Locleabc/DryMachine/docs/wiring.html

DryMachine · bộ điều khiển máy sấy tách ẩm

# Sơ đồ đấu dây STM32F103C8T6

Gán chân và cách nối từng module cho bản firmware hiện tại (Keil MDK, SHT45, relay 5V opto, nguồn tổ ong 12V). Tên User Label khớp với board.c trong repo.

MCU 3.3V12V → 5V → 3.3V25 chân đã dùng · 5 dự phòngRelay kích mức THẤP

## Chân trên Blue Pill

- Nguồn
- GND
- TFT · SPI1
- SHT45 · I2C2
- NTC dàn lạnh · ADC
- Relay
- Nút bấm
- Nạp / log
- Trống

Nhìn mặt linh kiện, cổng USB bên trái. Thứ tự in trên các bản clone có thể khác, hãy đối chiếu chữ in trên board trước khi hàn. Chân viền xám là chân trống; PA11/PA12 để trống vì dính USB, PA12 có sẵn điện trở kéo lên 1.5kΩ.

## Sơ đồ khối hệ thống

Nguồn đi từ trái sang, tín hiệu cảm biến vào bên phải, lệnh relay đi xuống dưới. Ray 5V từ buck cấp cho chân 5V Blue Pill, JD-VCC module relay, VCC màn hình TFT; ray 3.3V cấp thêm phân áp NTC; ray 3.3V lấy từ LDO trên Blue Pill.

## Hai chỗ dễ đấu sai

Mỗi NTC một mạch như trên (NTC buồng → PA0, NTC dàn lạnh → PA6). Dùng 3.3V của Blue Pill (không dùng 5V – ADC chỉ chịu 3.3V). NTC không phân cực.

Tháo jumper VCC–JD-VCC để cách ly: phía opto nuôi 3.3V từ Blue Pill, cuộn relay nuôi 5V từ buck. Máy nén không đi thẳng qua relay module: K1 chỉ đóng cuộn contactor KM, tiếp điểm chính của KM mới cấp cho máy nén (giữ nguyên rơ-le nhiệt OLR và tụ đề của điều hoà).

## Bảng nối dây từng module

### Nguồn

Chân module | Nối tới | Ghi chú
Nguồn tổ ong V+ 12V | Buck IN+ | CB 10A + cầu chì 1A phía 220V
Buck OUT+ 5V | Blue Pill 5V · relay JD-VCC · TFT VCC | Chỉnh buck đúng 5.0V trước khi nối
Buck OUT− / 12V V− | GND chung toàn mạch | Nối sao về một điểm
Blue Pill 3.3 | SHT45 VDD · phân áp 2 NTC · relay VCC (opto) | LDO onboard ~300 mA, đủ cho tải này

### TFT 3.2" ILI9341 (SPI1)

Chân module | Nối tới | Ghi chú
VCC | 5V | Module có LDO 3.3V riêng
GND | GND
CS | PA4
RESET | PB1
DC/RS | PB0
SDI (MOSI) | PA7
SCK | PA5
SDO (MISO) | — để trống | PA6 dùng cho NTC dàn lạnh
LED | PA11 | Đèn nền – firmware tắt khi không bấm nút (tự tắt màn hình). Không dùng: nối 3.3V
T_CLK … T_IRQ | để trống | Cảm ứng chưa dùng

### SHT45 (I2C2)

Chân module | Nối tới | Ghi chú
VDD | 3.3V | Tụ 100nF sát cảm biến
GND | GND
SCL | PB10 | Pull-up 4.7kΩ lên 3.3V nếu module chưa có
SDA | PB11 | Pull-up 4.7kΩ lên 3.3V; dây ≤ 1 m, cáp xoắn

### 2 NTC: buồng sấy (PA0) + dàn lạnh (PA6)

Dây | Nối tới | Ghi chú
NTC buồng – dây A | PA0 | 10kΩ 1% từ PA0 lên 3.3V, tụ 100nF PA0–GND
NTC buồng – dây B | GND | Đầu dò chịu nhiệt (vỏ inox), đặt giữa buồng, tránh gió trực tiếp từ dàn nóng
NTC dàn lạnh – dây A | PA6 | 10kΩ 1% từ PA6 lên 3.3V, tụ 100nF PA6–GND
NTC dàn lạnh – dây B | GND | Kẹp đầu dò sát ống đồng dàn lạnh (đầu ra van tiết lưu / cuối dàn)

### Module relay 3 kênh 5V opto

Chân module | Nối tới | Ghi chú
VCC | 3.3V | Nuôi opto bằng 3.3V để tắt dứt khoát
GND | GND
IN1 | PB4 | Máy nén (qua contactor) – kích mức CAO; 10kΩ PB4→GND
IN2 | PB5 | Quạt dàn lạnh
IN3 | PB6 | Quạt dàn nóng S1 (cấp ≥ 1)
IN4 | PB7 | Quạt dàn nóng S2 (cấp ≥ 2)
IN5 | PA1 | Quạt dàn nóng S3 (cấp ≥ 3)
IN6 | PA2 | Quạt dàn nóng S4 (cấp ≥ 4)
IN7 | PA3 | Quạt dàn nóng S5 (cấp 5)
JD-VCC | 5V buck | Tháo jumper VCC–JD-VCC
GND (cạnh JD-VCC) | GND buck

### Nút bấm (pull-up nội)

Chân module | Nối tới | Ghi chú
UP | PB8 ↔ GND
DOWN | PB9 ↔ GND
ENTER | PA8 ↔ GND
EXIT | PA15 ↔ GND | Cần SYS Debug = Serial Wire

### Nạp code & log

Chân module | Nối tới | Ghi chú
ST-Link SWDIO / SWCLK | Header SWD (PA13 / PA14) | Kèm GND, 3.3V
USB-UART RX | PA9 (TX) | 115200 8N1
USB-UART TX | PA10 (RX)
USB-UART GND | GND | Không nối 5V của USB-UART khi board đã có nguồn

## Cấu hình chân trong CubeMX

Đặt đúng User Label để main.h sinh ra các macro mà board.c dùng. SYS → Debug = Serial Wire (giải phóng PA15, PB3, PB4). Chân dự phòng: PB3 (IN8), PA12.

Chân | Chức năng | CubeMX mode | User Label | Mức khởi động
PA0 | NTC buồng sấy | ADC1_IN0 | NTC_EVAP1 | –
PA1 | Relay quạt nóng S3 (IN5) | GPIO_Output | RLY_FAN_S3 | High (= OFF)
PA2 | Relay quạt nóng S4 (IN6) | GPIO_Output | RLY_FAN_S4 | High (= OFF)
PA3 | Relay quạt nóng S5 (IN7) | GPIO_Output | RLY_FAN_S5 | High (= OFF)
PA4 | TFT CS | GPIO_Output | TFT_CS | High
PA5 | TFT SCK | SPI1_SCK | – | –
PA6 | NTC dàn lạnh | ADC1_IN6 | NTC_EVAP2 | –
PA7 | TFT SDI | SPI1_MOSI | – | –
PA8 | Nút ENTER | GPIO_Input, Pull-up | BTN_ENTER | –
PA9 | Log TX | USART1_TX | – | –
PA10 | Log RX | USART1_RX | – | –
PA11 | Đèn nền TFT | GPIO_Output (board.c) | – | High (sáng)
PA13 | SWDIO | SYS_JTMS-SWDIO | – | –
PA14 | SWCLK | SYS_JTCK-SWCLK | – | –
PA15 | Nút EXIT | GPIO_Input, Pull-up | BTN_EXIT | –
PB0 | TFT DC | GPIO_Output | TFT_DC | Low
PB1 | TFT RESET | GPIO_Output | TFT_RST | High
PB4 | Relay máy nén (IN1) | GPIO_Output | RLY_COMP | Low (= OFF, kích mức cao)
PB5 | Relay quạt dàn lạnh (IN2) | GPIO_Output | RLY_FAN_EVAP | High (= OFF)
PB6 | Relay quạt nóng S1 (IN3) | GPIO_Output | RLY_FAN_S1 | High (= OFF)
PB7 | Relay quạt nóng S2 (IN4) | GPIO_Output | RLY_FAN_S2 | High (= OFF)
PB8 | Nút UP | GPIO_Input, Pull-up | BTN_UP | –
PB9 | Nút DOWN | GPIO_Input, Pull-up | BTN_DOWN | –
PB10 | SHT45 SCL | I2C2_SCL | – | –
PB11 | SHT45 SDA | I2C2_SDA | – | –
PC13 | LED chạy | GPIO_Output | LED_RUN | High (LED tắt)

## Trước khi cấp điện 220V

An toàn điệnTách riêng máng dây 220V và dây tín hiệu. Vỏ tủ, dàn và máy nén phải nối đất. Đấu RC snubber (100Ω + 0.1µF X2) hoặc varistor song song cuộn contactor và quạt để relay không đánh lửa làm treo MCU.

1. Chỉnh buck ra đúng 5.0V khi chưa nối tải.
2. Cấp 12V, đo chân 3.3 của Blue Pill được 3.25–3.35V.
3. Tháo jumper VCC–JD-VCC; VCC module relay nối 3.3V, JD-VCC nối 5V.
4. Chưa nối tải 220V, nạp firmware: cả 7 relay phải nhả khi khởi động (PB5–PB7, PA1–PA3 mức High; PB4 máy nén mức Low).
5. Đo PA0 / PA6 ở nhiệt độ phòng (~25 °C): khoảng 2.2V.
6. Log UART hiện nhiệt độ buồng (NTC PA0) hợp lý và SHT45 không báo lỗi (SHTerr đứng yên).
7. Thử bảo vệ: rút NTC buồng (PA0) phải báo Mất cảm biến nhiệt và cắt relay.
8. Sau cùng mới đấu contactor, quạt, máy nén.
