Locleabc/DryMachine/App/app.h

/**
 * @file    app.h
 * @brief   Điểm vào ứng dụng. main.c: App_Init() sau MX_xxx_Init(), App_Loop() trong while(1).
 */
#ifndef APP_H
#define APP_H

void App_Init(void);
void App_Loop(void);

#endif
