Locleabc/DryMachine/(commit log)

2026-09-27 docs: khởi tạo repo, README, sơ đồ chân và hướng dẫn CubeMX
    - Chốt phần cứng: STM32F103C8T6, MAX31865, RS485 Modbus, ILI9341, 3 relay, 4 nút
    - docs/PINOUT.md: bảng gán chân + lưu ý phân áp cảm biến áp suất
    - docs/CUBEMX_SETUP.md: cấu hình ngoại vi và cách gắn App/ vào main.c
    Claude-Session: https://claude.ai/code/session_01Q4RsSUfkgXaCjxshzdnzJP
2026-09-27 feat(bsp): thêm app_config.h, driver relay và nút bấm
    - app_config.h: handle ngoại vi, hằng số hiệu chuẩn PT100/áp suất/RS485, chu kỳ task
    - bsp_relay: 3 relay (máy nén, quạt dàn nóng, quạt dàn lạnh), mức kích cấu hình được
    - bsp_button: 4 nút active-low, chống dội 30 ms, sự kiện CLICK / LONG (1 s) / REPEAT (UP, DOWN)
    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
2026-09-27 feat(sensor): driver PT100/MAX31865, áp suất analog, độ ẩm RS485 Modbus
    - drv_max31865: SPI mode 1, chuyển đổi liên tục, Callendar-Van Dusen, phát hiện lỗi đứt/chập
    - drv_pressure: ADC oversample x8 + lọc EMA, quy đổi 0.5-4.5 V -> bar, báo lỗi đứt dây
    - drv_humidity: Modbus RTU FC04 non-blocking (Transmit + Receive_IT + timeout),
    CRC16, mặc định kiểu XY-MD02 - chỉnh thanh ghi trong app_config.h khi chốt mã cảm biến
    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
2026-09-27 feat(tft): driver ILI9341 SPI + font ASCII 5x7
    - Khởi tạo ILI9341, xoay màn hình (mặc định ngang 320x240), RGB565
    - FillRect dùng buffer dòng 64 px, vẽ ký tự/chuỗi có scale và tô nền (chống nhấp nháy)
    - Font 5x7 ký tự 0x20..0x7E (UI dùng tiếng Việt không dấu)
    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
2026-09-27 fix(button): ENTER/EXIT phát CLICK khi nhả để tách biệt nhấn ngắn và giữ lâu
    Trước đó CLICK phát ngay khi nhấn nên giữ ENTER để Start/Stop sẽ mở menu trước.
    UP/DOWN vẫn phát CLICK khi nhấn + REPEAT khi giữ.
    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
2026-09-27 feat(settings): bảng thông số vận hành lưu Flash + tiện ích định dạng số
    - settings_t: nhiệt/ẩm đặt + trễ, quá nhiệt, áp cao/thấp, thời gian bảo vệ máy nén,
    trễ khởi động, quạt chạy thêm, thời gian sấy, chế độ quạt dàn nóng
    - Bảng param_desc_t (tên, đơn vị, min/max/step) dùng chung cho menu
    - Lưu page 63 (0x0800FC00) với magic + version + CRC32, đọc lại kiểm tra
    - util_fmt: Fmt_Float/Fmt_Time không cần printf float
    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
2026-09-27 feat(ctrl): máy trạng thái điều khiển máy sấy và bảo vệ máy nén
    - Trạng thái IDLE -> STARTING -> RUNNING -> STOPPING, FAULT (latched, reset bằng tay)
    - Máy nén chạy theo nhu cầu nhiệt + ẩm có trễ; mất cảm biến ẩm -> chỉ theo nhiệt (cảnh báo)
    - Bảo vệ: min-off (kể cả sau khi cấp điện), min-on, áp cao, áp thấp (bỏ qua 60 s đầu),
    quá nhiệt, lỗi cảm biến nhiệt/áp (lọc 5 chu kỳ)
    - Quạt dàn lạnh chạy trước máy nén và chạy thêm sau khi dừng
    - Quạt dàn nóng: mode 0 theo máy nén, mode 1 xả nhiệt theo nhiệt độ; ép chạy khi áp >= 90% ngưỡng cao
    - Hẹn giờ sấy (0 = kh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
2026-09-27 feat(ui,app): giao diện TFT + menu cài đặt, bộ lập lịch App_Init/App_Loop
    - ui_menu: màn hình chính (nhiệt/ẩm/áp, trạng thái, 3 relay, dòng lỗi/cảnh báo/thời gian)
    menu thông số cuộn 8 dòng, sửa giá trị UP/DOWN, tự lưu Flash khi thoát menu
    - Phím: ENTER nhấn = menu, giữ ENTER = chạy/dừng, giữ EXIT = reset lỗi
    - Vẽ giá trị 500 ms/lần, có tô nền để không nhấp nháy
    - app.c: lập lịch theo HAL_GetTick (nút 10 ms, cảm biến 500 ms, RS485 1 s,
    điều khiển 200 ms, UI 100 ms, log UART1 2 s, LED 500 ms)
    Claude-Session: https://claude.ai/code/session_01Q4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
    [app.c, app.h]
2026-09-27 test: công cụ kiểm tra biên dịch và test logic điều khiển trên PC
    - tools/host_check/main.h: HAL giả lập + User Label theo PINOUT
    - check.sh: gcc -fsyntax-only -Wall -Wextra toàn bộ App/ (hiện 0 cảnh báo)
    - test_ctrl.c: 17 kịch bản cho ctrl_dryer (khởi động, min-off/min-on, trễ ẩm,
    áp cao, mất cảm biến, dừng + quạt chạy thêm) - tất cả PASS
    - docs: thêm bước giảm FLASH LENGTH xuống 63K để dành page lưu thông số
    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
2026-09-27 docs: chuyển sang Keil MDK-ARM, cảm biến ẩm SHT45 (I2C2), mô tả kiến trúc mới
    - Bỏ RS485/USART2, thêm I2C2 PB10 (SCL) / PB11 (SDA) cho SHT45
    - docs/KEIL_SETUP.md thay CUBEMX_SETUP.md: CubeMX -> MDK-ARM, groups, include paths,
    IROM1 = 0xFC00 để dành page lưu thông số, AC6 + MicroLIB, encoding UTF-8
    - docs/ARCHITECTURE.md: phân tầng board / drivers / services / control / ui / app
    và bảng quy tắc include để các phần không ràng buộc nhau
    - .gitignore cho Keil
    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
2026-09-27 refactor(drivers): tách driver thành module độc lập, nhận cấu hình qua struct
    - Mỗi driver 1 thư mục trong App/drivers/, chỉ include stm32f1xx_hal.h
    (không còn phụ thuộc app_config.h / main.h / tên chân CubeMX)
    - button: bảng button_hw_t truyền vào Init (mức nhấn, cho phép lặp), id = chỉ số bảng
    - relay: bảng relay_hw_t có mức kích riêng từng relay
    - max31865: instance max31865_t + max31865_cfg_t (SPI, CS, Rref, R0, 2/3/4 dây)
    - press_analog: chỉ đọc điện áp + hàm quy đổi thuần; lọc số chuyển lên tầng services
    - ili9341: ili9341_cfg_t (SPI, CS, DC, RST)
    - flash_store (mới): ghi/đọc khối dữ liệu vào p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
2026-09-27 feat(drivers): driver SHT4x (SHT45) qua I2C, đo không chặn
    - Soft reset + đọc serial khi Init
    - StartMeasure / BusyTimeMs / ReadResult để không chặn vòng lặp chính
    - 3 mức chính xác (high 10 ms, medium 5 ms, low 2 ms), kiểm CRC-8 (0x31)
    - Quy đổi T = -45 + 175*S/65535, RH = -6 + 125*S/65535 (kẹp 0..100)
    - Hỗ trợ lệnh heater tích hợp (chống trôi khi độ ẩm cao lâu ngày)
    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
    [sht4x.c, sht4x.h]
2026-09-27 refactor(control): dryer_ctrl thành module logic thuần C, không phụ thuộc phần cứng
    - Không include HAL / relay / settings; không biến toàn cục (instance dryer_ctrl_t)
    - DryerCtrl_Step(ctrl, params, input, now) -> dryer_output_t; app tự đẩy ra relay
    - Lệnh qua DryerCtrl_Command (START/STOP/TOGGLE/RESET_FAULT) thay cho gọi hàm trực tiếp
    - dryer_params_t + DryerCtrl_DefaultParams() định nghĩa ngay tại control
    - Logic giữ nguyên như bản trước (18/18 kịch bản test PASS, xem commit test)
    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
    [dryer_ctrl.c, dryer_ctrl.h]
2026-09-27 refactor(services): tách sensors / settings / log / sched / util_fmt thành dịch vụ độc lập
    - sensors: gom PT100 + SHT45 + áp suất, lọc EMA áp suất, bù sai số, đánh giá hợp lệ;
    SHT45 đọc không chặn mỗi 1 s, lỗi 3 lần -> mất cảm biến ẩm, 5 lần -> gọi bus_recover
    (callback do app/board cung cấp) rồi init lại
    - settings: settings_t chứa dryer_params_t + bù nhiệt/ẩm; lưu qua flash_store
    (cấu hình truyền vào Init), bảng settings_param_t cho menu; version 2
    - log: printf qua hàm ghi truyền vào (không biết UART)
    - sched: bộ lập lịch bảng task tổng quát
    - util_fmt: Fmt_Float không dùng width '*' để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
2026-09-27 refactor(ui): giao diện độc lập với điều khiển, cảm biến và settings
    - ui_view_t: app điền sẵn dữ liệu hiển thị (UI không include dryer_ctrl/sensors)
    - ui_param_if_t: 4 con trỏ hàm count/desc/get/set để menu đọc-sửa thông số bất kỳ
    - ui_cmd_cb_t: UI chỉ phát lệnh START_STOP / RESET_FAULT / SAVE_SETTINGS
    - ui_key_t/ui_press_t riêng, không phụ thuộc driver nút bấm
    - Thời gian truyền vào UI_Update (không gọi HAL_GetTick) -> UI chỉ còn phụ thuộc ili9341
    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
2026-09-27 refactor(app,board): tách cấu hình phần cứng vào board/, app.c chỉ còn là keo nối
    - board.h/.c: bảng relay, nút, cấu hình MAX31865 / SHT45 / áp suất / TFT / page Flash;
    nơi duy nhất include main.h (tên chân CubeMX). Thay thế app_config.h
    - Board_I2cRecover(): 9 xung SCL + STOP + reset khối I2C2 để gỡ treo bus SHT45
    - app.c: khởi tạo module, adapter settings -> ui_param_if_t, xử lý ui_cmd_t,
    chép sensors -> dryer_input_t -> relay, dựng ui_view_t; lập lịch bằng services/sched
    - Xoá thư mục App/Inc, App/Src cũ
    Claude-Session: https://claude.ai/code/session_01Q4RsSUfkgXaCjxshzd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
    [app.c, app.h, board.c]
2026-09-27 test(host_check): kiểm tra cú pháp, quy tắc phụ thuộc giữa tầng và test logic điều khiển
    - stm32f1xx_hal.h + main.h giả lập (thêm I2C, GPIO_Init, RCC reset)
    - check.sh: (1) gcc -Wall -Wextra toàn bộ App/, (2) bắt vi phạm include theo
    docs/ARCHITECTURE.md (driver include driver khác, control dùng HAL, ui dùng settings...),
    (3) chạy test_ctrl
    - test_ctrl.c viết lại cho API DryerCtrl_*, biên dịch KHÔNG cần HAL: 18/18 PASS
    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
    [main.h]
2026-09-27 docs(wiring): sơ đồ đấu dây trực quan + relay opto kích mức thấp
    - docs/wiring.html: sơ đồ chân Blue Pill, sơ đồ khối, mạch phân áp cảm biến áp,
    đấu module relay (JD-VCC) + sơ đồ thang 220V (K1 -> contactor -> máy nén),
    bảng nối dây từng module, bảng cấu hình CubeMX, checklist trước khi cấp điện
    - PINOUT.md: thêm chuỗi nguồn 220V -> 12V -> 5V -> 3.3V, relay khởi động mức High
    - board.c: relay dùng module 5V opto kích mức THẤP (GPIO_PIN_RESET = đóng)
    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
2026-09-27 feat(services): chế độ sấy đặt sẵn, lịch sử lỗi, ngày giờ; settings v3
    - presets: 6 chế độ đặt sẵn (Rau thom, Rau cu, Trai cay, Nam, Thit - Ca, Hat - Nong) + Tu do
    - settings v3: lưu giá trị từng chế độ (sửa được), chế độ đang dùng, thời gian sấy phút;
    bỏ điểm đặt/thời gian sấy khỏi menu kỹ thuật (đã có màn hình riêng)
    - fault_log: 16 lỗi gần nhất (thời điểm + mã), vòng đệm lưu Flash page 62, có CRC
    - datetime: đổi giây-từ-2000 <-> ngày giờ cho bộ đếm RTC 32 bit
    - dryer_ctrl: tên lỗi ngắn gọn (không tiền tố 'LOI:') để dùng cho lịch sử
    - button: giữ lâu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
2026-09-27 feat(ui): giao diện 4 trang, menu chế độ sấy, nhập số từng chữ số
    - Tách UI thành mỗi màn hình 1 file (ui_screen_t), ui_core lo header/footer/chuyển màn hình
    - Trang 1 chính: nhiệt độ/độ ẩm thực tế (số lớn) + điểm đặt, chế độ, trạng thái, relay, thời gian
    - Trang 2 chạy/dừng, trang 3 thời gian sấy HH:MM, trang 4 lịch sử lỗi; UP/DOWN chuyển trang
    - Header có đồng hồ thời gian thực HH:MM:SS
    - Giữ ENTER 3 s: menu 6 chế độ + Tu do + chỉnh đồng hồ; ENTER áp dụng, giữ ENTER sửa chế độ
    - ui_edit: nhập từng chữ số trái sang phải, UP/DOWN đổi số, ENTER sang số kế / l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
2026-09-27 feat(app,board): RTC thời gian thực, nối UI mới với settings/lịch sử lỗi
    - board: Board_RtcInit/Read/Write đọc thẳng bộ đếm RTC (LSE 32.768 kHz), BKP_DR1 đánh dấu đã chỉnh giờ;
    thêm vùng Flash page 62 cho lịch sử lỗi
    - app: xử lý lệnh UI (chọn/sửa chế độ, thời gian sấy, chỉnh giờ, xoá lỗi/lịch sử),
    ghi lịch sử mỗi khi xuất hiện lỗi mới, dựng ui_view_t (đồng hồ, chế độ, lịch sử)
    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
2026-09-27 test(ui): mô phỏng giao diện trên PC với màn hình giả lập
    - ui_sim/ili9341_sim.c: cùng API driver ILI9341, vẽ vào framebuffer, xuất ảnh PPM
    - ui_sim/sim_main.c: chạy nguyên App/ui, bấm phím theo kịch bản, kiểm 8 tình huống
    (chạy/dừng, thời gian sấy 15:30, xoá lỗi, chọn chế độ, Tu do 62C 24%, chỉnh giờ,
    menu kỹ thuật, huỷ nhập) + báo chữ vẽ tràn màn hình
    - check.sh thêm bước 4; stub HAL thêm RTC/BKP
    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
2026-09-27 docs(ui): hướng dẫn giao diện + ảnh màn hình, cấu hình RTC và Flash cho Keil
    - docs/UI.md: bảng phím từng trang/menu, ảnh chụp từ bộ mô phỏng
    - KEIL_SETUP: bật LSE + RTC (không bật Calendar), IROM1 Size = 0xF800
    - PINOUT: thạch anh 32.768 kHz PC14/PC15, pin CR2032 ở VBAT
    - ARCHITECTURE: danh sách file màn hình trong ui/
    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
2026-09-27 build: file CubeMX DryMachine.ioc cấu hình sẵn + script gắn App/ vào Keil
    - DryMachine.ioc: STM32F103C8T6, 72 MHz (HSE x9), LSE + RTC (Activate Clock Source, không Calendar),
    SPI1 (TFT, /4), SPI2 (MAX31865, mode 1, /16), I2C2 100 kHz, USART1 115200, ADC1 IN0 239.5 cycles,
    SWD, đủ User Label + mức khởi động (relay/CS = High, nút pull-up), toolchain MDK-ARM, stack 0x800
    - tools/keil_setup.py: sau khi Generate, thêm nhóm App/* + include path, IROM1 = 0xF800, MicroLIB,
    gnu11, chèn App_Init/App_Loop vào main.c; chạy lại được, giữ bản .bak
    - docs/KEIL_SETUP.md: cách nhanh 3 bước + hướng dẫn làm tay từng mục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
2026-09-27 fix(board): khai báo extern handle HAL ngay trong board.c
    CubeMX bật 'pair .c/.h' nên hspi1/hspi2/hi2c2/hadc1/huart1 nằm trong spi.h, i2c.h... chứ không
    phải main.h -> board.c báo 'undeclared'. Khai báo extern tại board.c để chạy được với cả hai cách sinh code.
    app.c: bỏ cảnh báo format-truncation khi định dạng ngày giờ lịch sử lỗi.
    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
    [app.c, board.c]
2026-09-27 fix(keil_setup): chặn MX_RTC_Init đặt lại giờ 00:00 mỗi lần khởi động
    CubeMX luôn sinh HAL_RTC_SetTime/SetDate trong MX_RTC_Init. Script chèn vào vùng USER CODE
    Check_RTC_BKUP: nếu BKP_DR1 = 0xA5A5 (đã chỉnh giờ) thì return, giữ bộ đếm RTC chạy bằng pin VBAT.
    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
2026-09-27 build: code CubeMX sinh cho Keil MDK-ARM + đã gắn App/
    - Core/, Drivers/ (HAL F1), MDK-ARM/ do STM32CubeMX sinh từ DryMachine.ioc
    - Đã chạy tools/keil_setup.py: 28 file App/*.c trong 6 nhóm, 12 include path, IROM1 = 0xF800,
    MicroLIB, main.c gọi App_Init/App_Loop, rtc.c không xoá giờ khi đã chỉnh
    - Đã kiểm tra: tên chân khớp board.c, SPI2 mode 1, relay/CS khởi động mức High, JTAG tắt (PA15 dùng được)
    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
2026-09-27 test(gcc_check): biên dịch + liên kết toàn bộ firmware bằng arm-none-eabi-gcc
    Bắt lỗi biên dịch/liên kết khi chưa mở Keil. Kết quả hiện tại: 0 lỗi, 0 cảnh báo trong App/,
    Flash 37.1 KB / 62 KB, RAM ~4 KB / 20 KB (gồm stack 2 KB).
    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
2026-09-28 fix(keil): IROM1 bắt đầu 0x08000000 – sửa lỗi 'Flash Download failed - Cortex-M3'
    keil_setup.py chỉ đặt Size = 0xF800 mà không đặt StartAddress; CubeMX để trống (= 0x0) nên
    chương trình bị liên kết ở 0x00000000 (map: LR_IROM1 Base 0x00000000) và ST-Link không nạp được.
    - uvprojx: IROM1 = 0x8000000 / 0xF800
    - keil_setup.py: luôn đặt cả StartAddress; chỉ tạo .bak lần đầu (không ghi đè bản gốc khi chạy lại)
    - Kèm cấu hình Keil đã lưu (pack STM32F1xx_DFP 2.4.1, ARMCC 5.06, ST-Link SWD) và RTE/
    Claude-Session: https://claude.ai/code/session_01Q4RsSUfkgXaCjxshzdnz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
2026-09-28 chore: push.bat – bấm đúp để đẩy code lên GitHub
    Tự thêm safe.directory (repo được tạo từ máy ảo nên Git for Windows báo 'dubious ownership'),
    đặt remote origin = https://github.com/Locleabc/DryMachine.git rồi git push -u origin main.
    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
2026-09-28 feat(font): bộ tạo font tiếng Việt + font Be Vietnam Pro dạng bitmap
    - tools/fontgen/fontgen.py: TTF -> bitmap anti-alias 2 bit/pixel, cắt sát phần có mực, sinh fonts_vn.c
    - font_vn16 (15 px, 233 ký tự: ASCII + 134 chữ cái có dấu + ° · • – …) ~9.5 KB
    - font_num (46 px, 0-9 . - : % ° C) ~3.8 KB cho số lớn
    - Be Vietnam Pro, SIL Open Font License 1.1 (tools/fontgen/OFL.txt)
    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
2026-09-28 feat(ili9341): vẽ chữ UTF-8 tiếng Việt anti-alias
    - ILI9341_BlitBegin/BlitPixels/BlitEnd: đẩy khối điểm ảnh tuỳ ý
    - ili9341_text: giải mã UTF-8, tìm glyph nhị phân, trộn màu 4 mức, Text_Draw / Text_Width /
    Text_Box (căn trái-giữa-phải, tô nền phần thừa để xoá chữ cũ, không vẽ ký tự bị cắt)
    - fonts_vn.c sinh tự động
    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
2026-09-28 feat(ui): giao diện tiếng Việt có dấu, bố cục theo pixel
    - Mọi màn hình dùng font_vn16; số đo lớn, thời gian sấy, màn nhập số dùng font_num
    - Widget đổi sang ô rộng theo pixel (w_text/w_num/w_label), header/footer vẽ lại theo font mới
    - Nhập số: đọc chuỗi UTF-8, hỗ trợ xuống dòng; chỉnh đồng hồ 2 dòng (ngày-tháng-năm / giờ:phút)
    - Chuỗi tiếng Việt: tên chế độ, tên lỗi, trạng thái, thông số kỹ thuật, thông báo, màn khởi động
    - ui_view_t thêm hum_reached (độ ẩm đạt mục tiêu -> số màu xanh)
    Claude-Session: https://cla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
2026-09-28 build/test: Keil --no_multibyte_chars cho ARMCC 5, mô phỏng + kiểm tra phụ thuộc cho font mới
    - keil_setup.py: thêm --no_multibyte_chars (chuỗi UTF-8), 2 file .c mới vào nhóm App/drivers
    - check.sh: driver được include header cùng thư mục; mô phỏng biên dịch kèm font + text
    - ui_sim: giả lập Blit; docs/UI.md: mục font + ảnh màn hình tiếng Việt
    - Build thử arm-none-eabi-gcc: 51.5 KB / 62 KB Flash
    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
2026-09-28 feat(control): chế độ Tự động / Thủ công 5 giai đoạn, quạt dàn nóng 5 cấp
    - Tự động: quạt cấp auto_fan (mặc định 3); máy nén chạy liên tục tới khi đạt độ ẩm -> dừng,
    sau đó giữ nhiệt độ bỏ qua độ ẩm tới hết thời gian sấy -> làm mát tới nhiệt độ dừng -> kết thúc
    - Thủ công: GĐ1 quạt chạy trước 60 s rồi máy nén chạy tới nhiệt độ đặt, GĐ2 giữ nhiệt tới độ ẩm đặt,
    GĐ3/GĐ4 giữ nhiệt theo phút, GĐ5 tắt máy nén làm mát tới nhiệt độ dừng; mỗi GĐ 1 cấp quạt;
    bỏ qua thời gian sấy trang 3
    - Máy nén chờ bật lại (comp_min_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
2026-09-28 feat(settings,board): thông số chu trình v4 + 5 relay tốc độ quạt dàn nóng
    - settings v4: chế độ điều khiển (chữ Tự động/Thủ công), cấp quạt tự động + từng GĐ, GĐ1 quạt chạy trước,
    thời gian GĐ3/GĐ4, nhiệt độ dừng GĐ5, máy nén chờ bật lại, nhiệt độ bảo vệ; chia 2 nhóm
    (trang chu trình / menu kỹ thuật); tham số có thể hiển thị dạng chữ (choices)
    - board: relay COMP, FAN_EVAP, FAN_S1..S5 (PB6, PA1, PA2, PA3, PB4), module relay 8 kênh
    - DryMachine.ioc + Core/Inc/main.h + Core/Src/gpio.c: thêm PA1/PA2/PA3/PB4 output mức High,
    PB6 đổi nhãn RLY_FAN_S1 (sửa sẵn code sinh, không b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
2026-09-28 feat(ui): trang 4 Quạt dàn nóng, danh sách cài đặt dùng chung, hiển thị giai đoạn
    - 5 trang: Chính, Chạy/Dừng, Thời gian sấy, Quạt dàn nóng, Lịch sử lỗi
    - Trang 4: chế độ, bảng 5 GĐ kèm cấp quạt (tô GĐ đang chạy), bảo vệ; ENTER -> danh sách cài đặt
    - ui_list (thay ui_menu_tech): danh sách thông số dùng chung cho menu kỹ thuật và cài đặt chu trình,
    giá trị dạng chữ (Tự động/Thủ công, Tắt/Bật)
    - Trang chính: giai đoạn đang chạy, badge QN + cấp quạt, còn lại theo chế độ
    - Trang 2: thêm dòng giai đoạn + chế độ; trang 3: báo không áp dụng khi Thủ công
    - app: nố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
2026-09-28 docs/build: hướng dẫn chế độ điều khiển + ảnh màn hình, cập nhật project Keil
    - docs/UI.md: 5 trang, mô tả Tự động / Thủ công 5 GĐ, bảo vệ máy nén
    - Keil: thêm fan_speed.c, ui_page_fan.c, ui_list.c (bỏ ui_menu_tech.c)
    - Build thử arm-none-eabi-gcc: 55.8 KB / 62 KB Flash
    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
2026-09-28 feat(sim): chế độ chạy giả lập khi chưa có cảm biến
    - services/sim_plant: mô hình buồng sấy thuần C (máy nén -> nóng + khô, quạt dàn nóng xả nhiệt,
    tắt máy nén -> nguội + ẩm tăng lại, áp suất theo máy nén)
    - app: nguồn số đo chọn giữa cảm biến thật / Mô hình / Chỉnh tay; đồng hồ bộ điều khiển tua nhanh
    x1/x10/x60/x300 (khoá liên động quạt vẫn theo thời gian thật); tạo lỗi mất CB nhiệt / ẩm / áp cao;
    relay thật mặc định TẮT khi giả lập; chỉ lưu RAM (reset = tắt giả lập); log UART gắn [SIM]
    - UI: giữ EXIT 3 s ở trang 2 mở danh sách GIẢ LẬP (không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
    [app.c, sim_plant.c, sim_plant.h]
2026-09-28 test/docs: chạy trọn chu trình với mô hình buồng sấy + hướng dẫn giả lập
    - tools/host_check/sim_cycle.c (bước 5 của check.sh): dryer_ctrl + sim_plant, in mốc từng giai đoạn
    Tự động ~256 phút, Thủ công ~240 phút, cả hai HOÀN THÀNH
    - ui_sim: kiểm tra mở giả lập, thoát không lưu Flash
    - docs/UI.md: mục Chạy giả lập, cách thử từng giai đoạn
    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
2026-09-28 feat(ui): trang 6 – trạng thái đầu ra relay ON/OFF
    - ui_page_outputs.c: 7 đầu ra (máy nén, quạt dàn lạnh, quạt nóng cấp 1–5) kèm chân IN/GPIO
    - ô ON xanh / OFF xám; giả lập không đóng relay → ON* vàng + ghi chú
    - view thêm out_cmd (yêu cầu) / out_relay (Relay_Get), cfg thêm output_names/pins
    - footer 6 ô số trang, docs/UI.md + ảnh màn hình
    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
2026-09-28 feat(sim): giả lập mặc định đóng relay thật để đo điện áp chân ra
    - "Relay thật" mặc định Bật: chân GPIO + relay chạy theo bộ điều khiển khi giả lập
    - trang 6: ENTER đảo Relay thật khi đang giả lập (UI_CMD_SIM_RELAY)
    - trang 6 ghi chú mức chân ra: ON = 0 V, OFF = 3.3 V (relay kích mức thấp)
    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
2026-09-28 fix(sim): bật giả lập tự xoá lỗi mất cảm biến để chạy được khi chưa gắn cảm biến
    - chưa gắn PT100 → khởi động báo "Mất cảm biến nhiệt" và khoá máy; vào giả lập gửi RESET_FAULT
    - thông báo "Đang lỗi – xem trang 5" (trang lỗi đã dời)
    - test_ctrl: kịch bản không cảm biến → giả lập → chạy (bảo vệ áp suất = Tắt)
    - docs: hướng dẫn chạy khi chưa có cảm biến nhiệt / áp suất
    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
    [app.c]
2026-09-28 feat(ui): test đầu ra – bật/tắt tay từng relay ở trang 6
    - ENTER vào test (chỉ khi máy Đang dừng / Lỗi), UP/DOWN chọn, ENTER bật/tắt, EXIT thoát + tắt hết
    - quạt dàn nóng vẫn qua khoá liên động 1 cấp + nghỉ 1 s; máy nén giữ thời gian chờ bật lại
    - test luôn đóng relay thật; chặn chạy sấy khi đang test; 10 phút không bấm → tự thoát
    - bỏ UI_CMD_SIM_RELAY (Relay thật chỉnh trong danh sách GIẢ LẬP)
    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
2026-09-29 feat(ctrl): quá nhiệt – làm mát cưỡng bức tới 30 °C mới hết lỗi
    - quá nhiệt: tắt máy nén, quạt dàn lạnh + quạt dàn nóng cấp 5 chạy liên tục
    - nhiệt độ ≤ "Quá nhiệt: nguội tới" (mặc định 30 °C, trang 4) → tự hết lỗi, về IDLE
    - chưa nguội thì không reset được lỗi, khoá test đầu ra; màn hình "Quá nhiệt · làm mát tới 30°C"
    - settings v5: ô hum_hyst (không dùng) → temp_recover, đọc được v4 giữ nguyên cài đặt cũ
    - sim_plant môi trường 28 °C; test_ctrl + sim_cycle quanhiet
    Claude-Session: https://claude.ai/code/session_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
    [app.c, dryer_ctrl.c, dryer_ctrl.h, settings.c, settings.h, sim_plant.c]
2026-09-29 feat(ui): trang 6 hiện nhiệt độ · độ ẩm · áp suất thay dòng ghi chú ON/OFF
    - dòng dưới cùng: T (cam) · RH (xanh) · áp suất bar, "--.-" khi mất cảm biến
    - chế độ test báo ở footer "TEST · ENTER bật/tắt · EXIT thoát"
    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
2026-10-04 fix(sht45): chẩn đoán lý do không đọc được + tự dò địa chỉ 0x44/0x45
    - driver phân biệt lỗi: không trả lời (NACK), bus bị giữ thấp (BUSY), CRC, timeout
    - SHT4X_Init tự thử địa chỉ còn lại khi không trả lời
    - khởi động gỡ treo bus I2C trước khi init (cờ BUSY kẹt của I2C STM32F1)
    - dòng cảnh báo trang chính ghi rõ lý do; log UART in địa chỉ + mã lỗi
    - docs/PINOUT.md: bảng xử lý sự cố SHT45
    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
    [app.c, sensors.c, sensors.h, sht4x.c, sht4x.h]
2026-10-04 feat(sensors): hỗ trợ SHT3x (SHT31-D) + chẩn đoán lỗi MAX31865/PT100
    - driver sht4x tự nhận SHT4x (lệnh 1 byte) hoặc SHT3x (lệnh 2 byte, RH = 100·raw/65535)
    - trang chính ghi rõ lý do mất PT100 theo thanh ghi lỗi MAX31865 (không phản hồi SPI, hở, chập, sai jumper, sai Rref)
    - log khởi động in loại SHT, địa chỉ, mã lỗi và thanh ghi lỗi PT100
    - docs/PINOUT.md: đấu SHT31-D, jumper 2/3/4 dây MAX31865, bảng xử lý sự cố
    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
2026-10-04 feat(ui): hiện nhiệt độ đo tại cảm biến ẩm SHT ở trang chính
    - dòng "Chế độ" bên phải: "SHT 28.3°C" (chỉ tham khảo, điều khiển vẫn dùng PT100)
    - ẩn khi cảm biến ẩm không đọc được
    Claude-Session: https://claude.ai/code/session_017fUgYe1KjDaqZScqSxtEce
2026-10-04 fix(pt100): lỗi "ngoài dải" hiện điện trở đo được + gợi ý nguyên nhân
    - driver MAX31865 trả thêm mã ADC, luôn có R kể cả khi nhiệt ngoài -50..250 °C
    - dòng cảnh báo: "PT100 R=xx ohm thấp: chập / Rref?" | "cao: hở / PT1000?" | "ngoài dải"
    - log UART lúc khởi động in thêm R của PT100
    - docs/PINOUT.md: bảng tra theo R + cách đo kiểm bằng đồng hồ
    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
    [app.c, max31865.c, max31865.h, sensors.c, sensors.h]
2026-10-04 docs(pinout): sửa cách hàn jumper + đấu dây PT100 3 dây cho MAX31865
    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
2026-10-04 feat(ui): tự tắt màn hình khi không bấm nút, bấm nút bất kỳ để sáng lại
    - thông số mới trang 4 "Tắt màn hình sau" (phút, mặc định 5, 0 = luôn sáng)
    - tắt: tô đen + tắt đèn nền TFT qua PA11 (cấu hình trong board.c, không sửa CubeMX)
    - bấm nút bất kỳ → sáng lại, lần bấm đánh thức bị bỏ qua tới khi nhả hết nút
    - có lỗi mới → tự sáng lại
    - settings v6, đọc được v4/v5 (giữ nguyên cài đặt cũ)
    - docs: UI.md, PINOUT.md, wiring.html
    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
2026-10-04 refactor(settings): chuyển "Tắt màn hình sau" sang menu kỹ thuật (giữ EXIT 3 s)
    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
2026-10-04 fix(pt100): lỗi giữ lại hiện lý do lúc hỏng, không lấy giá trị đang đo
    - chụp thanh ghi lỗi + R tại thời điểm PT100 hỏng (trước đây lấy R hiện tại → đọc lại
    được vẫn ghi "ngoài dải" với R bình thường, gây hiểu nhầm)
    - PT100 đã đọc lại nhưng lỗi còn giữ: dòng lỗi luân phiên 2 s lý do / "PT100 đã OK lại · xoá lỗi ở trang 5"
    - log UART mỗi lần hỏng: F, R, số lần (phát hiện chập chờn)
    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
    [app.c]
2026-10-05 fix(pt100): chờ 5 s sau bật nguồn mới khởi tạo + đọc MAX31865
    Mới bật nguồn hay báo "PT100 ngoài dải" và khoá máy (phải xoá lỗi tay).
    - MAX31865_Init chuyển từ Sensors_Init sang Sensors_Process sau SENSORS_PT100_START_MS (5 s)
    - trong lúc chờ: chưa chạy bộ điều khiển (relay nhả, không đếm mất cảm biến),
    trang chính hiện "Đang chờ cảm biến nhiệt…"
    - sensors_data_t.pt100_ready; log "PT100 hong" bỏ qua khi chưa sẵn sàng
    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
    [app.c, sensors.c, sensors.h]
2026-10-05 fix(max31865): tự phát hiện chip mất cấu hình và ghi lại, không cần rút nguồn module
    - mỗi lần đọc: đọc lại thanh ghi cấu hình, khác giá trị mong đợi (chip vừa cấp nguồn lại /
    sụt áp / nhiễu → 0x00, VBIAS tắt, RTD = 0) → đồng bộ SPI + ghi lại cấu hình, lần đọc sau có số
    - Init: phát 1 byte giả để SCK về mức nghỉ, ghi + đọc lại cấu hình (thử 3 lần)
    - 0xFFFF (MISO kẹt cao) cũng tính là không phản hồi (trước bị nhầm thành "hở mạch")
    - chẩn đoán: "MAX31865 không phản hồi (CFG=00/FF)" / "sai cấu hình"; log UART thêm CFG + số lần ghi lại
    - docs/PINOUT.md: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
    [app.c, max31865.c, max31865.h, sensors.c, sensors.h]
2026-10-05 feat(fan): quạt dàn nóng 5 cấp kiểu cộng dồn – cấp N đóng relay 1..N
    - cấp 1 = 1 relay … cấp 5 = 5 relay (trước: chỉ 1 relay theo cấp, đổi cấp nghỉ 1 s)
    - tăng cấp: đóng thêm từng relay cách 1 s (giảm dòng khởi động); giảm cấp / tắt: nhả ngay
    - test đầu ra trang 6: ENTER dòng cấp N → relay 1..N, bấm lại → cấp N-1
    - test logic + docs (PINOUT bảng relay theo cấp, cảnh báo không dùng cho motor nhiều đầu dây)
    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
2026-10-06 refactor(board): đổi chân relay cho tiện đi dây
    IN1 máy nén PB4 · IN2 quạt dàn lạnh PB5 · IN3..IN7 quạt dàn nóng S1..S5 = PB6, PB7, PA1, PA2, PA3
    - main.h / gpio.c / DryMachine.ioc (giữ nguyên User Label, chỉ đổi chân)
    - trang test đầu ra: ghi chú chân mới
    - docs PINOUT.md, wiring.html
    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
2026-10-06 feat(sensors): bỏ cảm biến áp suất, thêm 2 NTC 20k dàn lạnh + chống đóng băng
    Phần cứng
    - NTC dàn lạnh 1 → PA0 (ADC1_IN0), NTC 2 → PA6 (ADC1_IN6); mỗi NTC phân áp 20k 1% lên 3.3V + 100 nF
    - SPI1 (TFT) chỉ phát: bỏ MISO PA6; main.h/adc.c/spi.c/.ioc cập nhật nhãn NTC_EVAP1/2
    - driver mới drivers/ntc (tự chọn kênh ADC, phát hiện hở/chập, công thức B); xoá drivers/press_analog
    Điều khiển
    - chống đóng băng: dàn lạnh (thấp nhất của 2 NTC) ≤ −2 °C liên tục 60 s khi máy nén chạy → xả đá:
    tắt máy nén, quạt vẫn chạy, không dừng máy; ≥ 5 °C → chạy tiếp. Mất NTC chỉ cảnh bá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
2026-10-06 docs(sensors): sửa chú thích chu kỳ đọc
    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
2026-10-06 hw(ntc): điện trở phân áp NTC dàn lạnh 10k thay 20k
    r_fixed = 10000 trong board.c; docs cập nhật điện áp tham chiếu (25 °C ≈ 2.2 V, 0 °C ≈ 2.87 V)
    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
2026-10-13 fix(ntc): lọc gai nhiễu + chống báo mất NTC chập chờn
    Hay báo "Mất NTC dàn lạnh (PA0/PA6)" thoáng qua dù dây tốt.
    - NTC_ReadCode: bỏ mẫu ADC timeout (trước tính là 0), sắp xếp và bỏ 1/4 mẫu thấp + 1/4 mẫu cao
    (gai nhiễu từ relay / dây dài) rồi mới lấy trung bình
    - sensors: chỉ báo mất NTC sau 6 lần đọc lỗi liên tiếp (3 s); trong lúc đó giữ giá trị cũ
    - chẩn đoán: trang 6 hiện điện áp chân ADC khi NTC lỗi; log UART thêm mã ADC + số lần đọc lỗi
    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
2026-10-13 fix(build): Flash đầy (L6406E) – MAX31865 đọc bằng HAL_SPI_TransmitReceive
    Image vượt IROM 0xF800 (62 KB, chừa 2 page cuối cho cài đặt + lịch sử lỗi) 0x58 byte.
    read_regs dùng 1 lần TransmitReceive thay Transmit + Receive → không link HAL_SPI_Receive
    và SPI_EndRxTransaction (~0.43 KB).
    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
2026-10-13 fix(ntc): R25 và hệ số B riêng từng đầu dò theo đo thực tế
    Đo 2 điểm (0 °C nước đá / 28 °C): NTC 1 = 50k / 18k → R25 20 kΩ, B 3000;
    NTC 2 = 33k / 12.7k → R25 14 kΩ, B 2800 (trước dùng chung 20k / B 3950 → NTC 2 lệch ~+7 °C).
    - ntc_cfg_t thêm beta; board.c khai báo r25/beta mỗi đầu dò
    - bỏ mục "NTC dàn lạnh: B" trong menu kỹ thuật (field settings giữ chỗ, không đổi phiên bản)
    - PINOUT.md: công thức tính R25/B khi thay đầu dò
    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
2026-10-13 fix(ntc): đổi R25/B giữa PA0 và PA6 theo đầu dò đang cắm
    PA0 = 14 kΩ / B 2800 (33k @0 °C), PA6 = 20 kΩ / B 3000 (50k @0 °C)
    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
2026-10-13 feat(board): đảo tín hiệu PB4 (máy nén) – mức CAO = đóng
    - board_relays[RLY_ID_COMP].active = GPIO_PIN_SET
    - gpio.c / .ioc: mức khởi động PB4 = Low (máy nén nhả khi cấp điện)
    - docs: PINOUT, KEIL_SETUP, wiring, UI; khuyên thêm 10 kΩ PB4 → GND
    (sau reset PB4 là NJTRST có pull-up nội vài ms trước khi firmware cấu hình)
    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
2026-10-14 feat: bỏ chế độ Tự động + đồng hồ RTC; GĐ3/GĐ4 chuyển theo độ ẩm giữ liên tục
    Chu trình (control)
    - chỉ còn chu trình 5 giai đoạn (bỏ PH_AUTO_*, thời gian sấy, cấp quạt tự động)
    - GĐ3: ẩm ≤ hum_gd3 (mặc định 12 %) LIÊN TỤC gd3_min (60 ph) → GĐ4
    GĐ4: ẩm ≤ hum_gd4 (10 %) LIÊN TỤC gd4_min (30 ph) → GĐ5
    ẩm > mức + 1 %RH → đếm lại; mất cảm biến ẩm → chỉ tính thời gian
    - status: hold_counting, phase_left_s = thời gian giữ ẩm còn lại
    Bỏ đồng hồ thời gian thực (giảm code)
    - xoá rtc.c/h, datetime.c/h, Board_Rtc*, MX_RTC_Init, LSE; .ioc bỏ RTC + PC14/PC15
    - bỏ tran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
2026-10-14 feat(sensors): bỏ MAX31865/PT100 – nhiệt độ buồng đo bằng NTC ở PA0; dàn lạnh còn 1 NTC (PA6)
    - NTC buồng (PA0, R25 14k / B 2800 – đầu dò đang cắm) điều khiển nhiệt độ + bảo vệ quá nhiệt;
    lọc EMA, lỗi phải kéo dài 3 s mới báo mất (như NTC dàn lạnh)
    - NTC dàn lạnh còn 1 (PA6, 20k / B 3000), chống đóng băng dùng NTC này
    - xoá driver max31865, SPI2 (PB12–PB15 trống), chờ 5 s khởi động PT100, chẩn đoán PT100;
    .ioc / main.c / spi.c / gpio.c / Keil project cập nhật
    - lỗi "Mất cảm biến nhiệt": dòng lỗi ghi "NTC buồng (PA0) hở dây / chập – x.xxV" (điện áp lúc hỏng)
    - menu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
